markusg1234/ESP-Enclosure/esp-enclosure.scad

/* ===========================================================================
   ESP-Enclosure — a parametric ESP devkit case for OpenSCAD

   Copyright (c) 2026 markus1234
   Licensed under CC BY 4.0 — https://creativecommons.org/licenses/by/4.0/

   This model is an original design, written from scratch. It ships with
   slots.svg and wifi.svg, which are part of it and under the same licence.

   esphome.svg is NOT mine and NOT under CC BY 4.0: it is the ESPHome logo from
   Homarr Labs' dashboard-icons, under Apache 2.0, and modified. See
   "Third-party assets" in the README.

   IT IS WHAT THE LID CUTS BY DEFAULT — vent_file names it — so the attribution
   travels with anything you publish, print for someone else or sell. Point
   vent_file at slots.svg or wifi.svg, or set vents = false, and nothing here
   references it.

   The lid drops into a slot around the top of the wall and is held by ball
   latches: half-round bumps on its rib clicking into dimples in the slot wall.

   The devkit's two buttons — EN and BOOT — come up through that lid as a
   SEPARATE PRINTED PART each: a stem standing proud through a plain hole in the
   plate, a flange underneath that keeps the button captive, and a tip reaching
   down to the switch. The flange is the only part wider than the hole, so they
   are fed in from inside the lid, stem first, before the lid goes on. Print them
   with part = "button".

   Nothing on them flexes, and that is the whole point. This started as a
   printed flexure — the cap cut free on three spring arms so the lid stayed one
   part — and it broke after a few presses. Printed arms that survive one press
   do not survive a thousand.

   The board sits up on ledges; its header pins drop through a thin hole plate
   into a trough under each row. Dupont connectors push up into those troughs
   from below, so they finish flush with the floor instead of hanging out, and
   the wires leave straight down through the open underside.

   NO use<> OR include<> STATEMENTS. The geometry is all in this file, so the
   tray and the template render from it alone.

   The lid is the exception: its vents are cut from artwork in an SVG beside
   this one, named by vent_file. Three ship with it — esphome.svg (the ESPHome
   logo, the default, and the third-party one above), slots.svg (plain bars) and
   wifi.svg. That file has to travel with the model. Set vents = false and
   everything is standalone again.

   Open in OpenSCAD, then Window > Customizer. Pick a part with `part` at the
   top, press F6, then File > Export > STL.

   EVERY DIMENSION IS IN MILLIMETRES. The only settings that are not are the
   handful marked (in degrees), the plain counts, and the on/off switches.

   >> PRINT THE FIT TEMPLATE FIRST. Set part = "template". A shallow shell with
   >> the same footprint, the same interior outline and the same holes in the
   >> same places, so you can drop your actual board into it and see that it
   >> fits, that the header lines up and that the antenna has its bay — before
   >> committing to a whole case. The Dupont and board defaults below are
   >> sensible starting points, not verified specifications for your hardware.
   =========================================================================== */


/* [Part] */

// Which part to render
part = "tray";          // [tray:Tray (bottom), lid:Lid (top), button:Buttons - the two loose press buttons, template:Fit template - check your board fits, all:Print layout, assembled:Assembly preview]

// Gap between parts in the print layout (mm)
layout_gap = 5;         // [0:0.5:40]


/* [Pin header] */

// Pins per row. Two rows, one down each long side.
pin_count = 19;         // [1:60]


/* Centre-to-centre between the two rows, across the width. 22.86 is what most
   ESP devkits use; 25.4 is the other common one. (mm)
   */
// Centre-to-centre between the two pin rows, across the width. 25.4 is the other common one. (mm)
row_spacing = 22.86;    // [5:0.01:60]

/* Shift the whole header along the length: the holes, the pin channel, the
   Dupont troughs and the plinths that carry them, all together.

   NEGATIVE IS TOWARD THE USB END. The board itself cannot move — it sits hard
   against the inside of the USB wall so its socket meets the opening — so this
   is how you line the holes up with a header that is not centred on your board.

   The default is -1.0 because the header on a typical devkit sits that much
   closer to the USB edge than dead centre. Measure yours: it is the distance
   from the board's USB edge to the first pin, against the far edge to the last.
   */
// Shift the header along the length. Negative moves it toward the USB end. (mm)
pin_x_offset = -1.0;    // [-20:0.01:20]


/* [Pin pitch / Dupont preset] */

/* The three Dupont families, named by the thing you actually measure off your
   board: the pitch. Picking one sets the post size with it — 0.64 at 2.54,
   0.50 at 2.00, 0.40 at 1.27 — because a family is a pitch and a post together,
   not two things to line up by hand.

   This holds the pitch itself rather than a preset code, so the number in the
   dropdown is the number in the variable and there is nothing to decode.
   */
// Pin pitch: centre to centre along the header. Sets the Dupont post size too.
pin_pitch = 2.54;       // [2.54:2.54mm - standard, 2:2.00mm - compact, 1.27:1.27mm - micro]

/* Size the openings for the connector's PLASTIC SQUARE SURROUND instead of for
   the bare metal post, so a housed Dupont pushes up into the trough rather than
   only a naked crimp terminal. Off, everything is sized to the post, which is
   what it has always been.

   The surround is not a second measurement to take. Housings are moulded to
   TILE THE PITCH — that is exactly what lets a row of them sit shoulder to
   shoulder on a header — so their size IS the pitch, less the moulding gap that
   keeps two of them from jamming. 2.50 at the 2.54 preset, 1.96 at 2.00, 1.23
   at 1.27.

   That tiling is also why this tick MERGES THE ROW, and it is not a choice: at
   the 2.54 preset the opening becomes 2.70 against a 2.54 pitch, so the plate
   between one hole and the next is 0.32 mm of NEGATIVE material. There is no
   setting at which separate holes survive a surround. So while it is on:

   pin_slot      is on whatever it says — one continuous channel down the row
   pin_slot_w    is held at the opening's width if it is set below it
   pocket_wall   is 0 — the troughs merge into one slot down each row

   wire_channel_w is NOT one of them and keeps working normally. A wire channel
   is sized to the PIN, never to the surround: what goes along it is a wire off
   a pin, while the connector arrives from below and goes up through the plate.
   So it stays whatever you set — 0.84mm by default, with 1.70mm of rib between
   channels — exactly as with the tick off.

   The console says all of that when you tick it, so nothing goes quiet.

   terminal_len is worth a look alongside this, but there is no right answer to
   it and nothing warns: it is the trough's DEPTH, so it sets how much of the
   housing is buried and how much shows below the case. A housed Dupont is about
   15 mm, so at the default 6 roughly 9 mm of it is on display — which is a
   shorter case and an easier connector to unplug, if that is what you want.
   */
// Size the openings for the connector's plastic surround, not the bare pin.
dupont_housing = true;


/* Added to the post size to get the hole — or to the plastic surround, with
   dupont_housing ticked (mm). Raise if pins bind, lower if loose.
   */
// Added to the post (or the surround) to get the hole. Raise if pins bind. (mm)
hole_clearance = 0.2;  // [0:0.01:1.5]

// There is no lead-in chamfer on the holes, and no lead_in to set. The holes
// are plain square bores, top to bottom, at exactly `hole` across their whole
// depth.
//
// Losing the funnel costs less than it sounds like, because the hole is a
// CLEARANCE hole by construction: it is whatever has to pass through it plus
// hole_clearance, so it is already wider than that thing before anything is
// chamfered — half of hole_clearance per side. Against the bare post that is a
// hole 31% wider than the pin at 2.54 and 50% wider at 1.27; against a plastic
// surround the same slack is proportionally far less, because the surround is
// most of the pitch to begin with. Either way a pin was never being pressed
// into an interference fit that a funnel had to open up. The funnel only helped
// a pin FIND a hole it already fitted, and what does the finding is the pitch,
// which the header and the plate share.
//
// The exception is hole_clearance = 0, which the slider allows: that makes the
// hole exactly the post and there is no clearance left to speak of. Warned
// about below, since the funnel is no longer there to disguise it.

/* Replace the row of square clearance holes with ONE continuous channel running
   the length of the header. The pins still drop through it into the trough
   below and the terminals still push up from underneath — what goes away is the
   rib BETWEEN one hole and the next, which is what fails at a fine pitch: the
   1.27mm micro preset leaves pitch minus hole = 0.67mm of plate between holes,
   thinner than a single 0.4mm extrusion, so it prints as a smear rather than a
   wall.

   The price is location ALONG the row: nothing stops the header sliding
   lengthwise any more. The PCB rests and the board's own fit against the USB
   wall already do that.

   Forced on by dupont_housing, for the same reason at a coarser pitch: a
   surround leaves no rib between one hole and the next either.
   */
// Replace the row of holes with one continuous channel down each pin row.
pin_slot = true;

/* Channel width, and 0 is the default: as wide as a hole, which keeps the pins
   gripped across the row exactly as separate holes did. It is also the width that keeps the board where it is —
   see pin_slot, which only drops the board when the channel is wider than the
   header's strip.

   ANY OTHER VALUE GIVES THAT UP. At 4mm a 0.64mm pin has three millimetres of
   air around it: the channel is then clearance, not a fit, the pins are located
   in neither direction, and the board is held by its rests and the walls alone.
   That is a legitimate thing to want — it makes the pins trivial to drop in and
   leaves room to bring wires up beside them — but it is a different part.

   Keep it inside the pocket if you want the whole width to be a way through.
   Wider, and the channel is a wide pocket over a narrower opening: it still
   prints, and the pins still pass on the centreline, but only the pocket of it
   goes anywhere. The console tells you the opening you actually got.

   With dupont_housing on this is a request rather than the last word: anything
   below the opening's own width is raised to it, because a channel narrower
   than the surround is not a channel the surround goes through. Above it, it is
   yours as usual. (mm)
   */
// Pin channel width. 0 = as wide as a hole, which keeps the pins gripped. (mm)
pin_slot_w = 3;         // [0:0.1:10]

/* How far the channel cuts DOWN from the top face of the floor.

   There is a floor under this, and asking for less gets you the floor rather
   than an error: the channel has to get through the hole plate to reach the
   trough at all, so the minimum is hole_plate_t — 1.0 at the defaults. Below
   that it stops inside the plate and opens into nothing.

   Anything past the plate is optional. The trough is square, so the moment the
   channel breaks through it has the full pocket underneath it, and cutting
   deeper only removes more of the plinth. It is not the moving target it was
   when a tapering roof made the minimum depend on the trough and the roof angle.

   Ignored with the terminal recess off: there is no trough to reach, so the
   channel is simply cut through the floor the same depth the holes were. (mm)
   */
// How far the pin channel cuts down from the floor's top face. (mm)
pin_slot_depth = 3.0;   // [0.5:0.1:12]

/* A channel beside each pin hole, so you can bring a wire off a pin and out
   into the box instead of taking it down through the underside. It runs from
   the hole clear through the side of the plinth and opens onto the relieved
   floor.

   THE WIDTH IS THE SWITCH. 0 is no channel at all — plain holes — and any other
   value is that width in millimetres. There is no separate on/off tick: a tick
   and a width are two settings for one decision, and with both of them there was
   no way to see which one was the reason you had no channels.

   THE DEFAULT IS SIZED FOR THE WIRE, not for the pin: 1.2mm, which is 26 AWG
   with its insulation on, leaving 1.34mm of rib between one channel and the
   next at the 2.54 pitch. What travels down this channel is a wire, so the wire
   is what it is measured against. A channel at the pin's own 0.84 is narrower
   than common hook-up wire and the wire will not lie in it.

   That is a deliberate parting from the pin's hole, and the console reports it
   with both numbers so the rib you get is never a surprise. Matching the pin
   instead — 0.84 at 2.54, 0.70 at 2.00, 0.60 at 1.27 — is one number away, and
   it is the width at which the channels impose nothing the pin holes did not
   already impose. Nothing follows pin_pitch or hole_clearance on its own.

   The useful direction from here is DOWN. Narrowing buys back rib, which is the
   whole problem at a fine pitch: at the 1.27 micro preset even the pin's own
   0.60 leaves 0.67mm of plate and is too thin, while 0.45 leaves 0.82 and works.
   That is what makes wire channels possible there at all.

   Widening trades the other way, and the pitch caps it: two 0.4mm perimeters
   have to survive between one channel and the next. Ask for more and you get
   the most the pitch allows rather than an error, and the console says so.

   Every value on the slider does something:
   0             no channels
   under 0.4     raised to 0.4 — one extrusion. A narrower slot is not a slot,
                 the slicer simply fills it
   past the pitch the channels merge into one slot per row, which is a real part

   It is ONE setting, not the five it used to be — a tick plus slot_w, slot_neck,
   wire_w and slot_depth describing a keyhole with a neck, a wider section and
   its own length, every one of which could quietly break the channel.

   Works normally with dupont_housing on, and is unaffected by it. With the
   surround OFF the pin's hole is also the plate's hole, so the channel just
   continues it sideways. With it ON the hole is the surround's — 2.70 — and the
   channel deliberately does not follow: what goes along it is a wire off a pin,
   while the connector arrives from below. A 2.70 channel on a 2.54 pitch would
   merge every channel into one slot and take the inboard plinth wall with it.

   The direction and the length are not settings either, because neither has a
   second sensible value: it always runs toward the middle of the box, and
   always far enough to break clear through the plinth's side. Outboard is the
   side wall a couple of millimetres away, with nowhere to put a wire; stopping
   short of the plinth's face leaves a pocket the wire can never get out of.
   */
// Wire channel width, sized for the wire. 0 is no channel at all. (mm)
wire_channel_w = 1.2;   // [0:0.01:3]

/* How far the channel carries on BELOW the hole plate, into the trough.

   The channel has to pass through the plate to exist at all — that part is
   hole_plate_t and not a choice. This is the rest: the drop that opens a mouth
   into the trough's straight-sided section, so a wire can turn the corner and
   come out. Stop level with the plate's underside and that mouth is a sliver
   no wire fits through, which is what a 0 here gives you.

   AT THE CHANNEL'S OWN WIDTH THE MOUTH IS SQUARE, which is where the default
   sits: one width down for one width across. Shallower trades mouth for plinth,
   deeper costs nothing but the cut, so the useful direction is down only if you
   are short of plinth.

   Clamped to the trough's own depth, since past that there is nothing left to
   open into — and with a sealed base a deeper cut would breach the slab. With
   terminal_recess off there is no trough at all and this is held at 0: the
   channel is the plate's thickness and nothing more. The console says when the
   number you set was not the number you got. (mm)
   */
// How far the channel reaches below the hole plate, into the trough. (mm)
wire_channel_d = 1.2;   // [0:0.05:12]


/* [Terminal recess] */

/* Close the underside. The troughs are the only thing that opens through the
   bottom of the case, so this puts a slab of floor_solid under them and the
   case has no holes in its base.

   Nothing else changes: the pin holes, the troughs, the plinths, the wire
   channels and the rests all stay exactly as they are. The troughs simply
   become blind pockets, which is where the pin tails then sit — so a sealed
   base also removes any question of the tails fouling anything. The case grows
   by the thickness of the slab.
   */
// Close the underside with a solid slab, so the base has no holes in it.
seal_bottom = false;

/* Sink the Dupont connectors into a trough in the underside of the floor, so
   they finish flush instead of hanging below the case. The board sits up on
   its ledges, its pins drop through the hole plate, and the connectors push up
   into the trough from below. Wires leave straight out of the open underside.
   */
// Sink the connectors into troughs in the floor so they finish flush.
terminal_recess = true;

/* Trough depth, and therefore HOW MUCH OF THE CONNECTOR IS BURIED. Whatever is
   longer than this shows below the underside of the case.

   That is a dial, not a target. Bury the lot and the case is flush underneath
   but tall; leave some proud and the case is shorter and the connector is far
   easier to grip and unplug. About 6mm swallows a bare crimp terminal whole; a
   full plastic Dupont housing is nearer 15mm, so at 6 roughly 9mm of it shows.
   Neither is wrong, and nothing warns about it — set it to whatever leaves the
   amount of housing you want on display.

   It costs case height 1:1, because the floor is this plus hole_plate_t. That
   is the trade: every millimetre you bury is a millimetre of case. (mm)
   */
// Trough depth: how much connector is buried. The rest shows below the case. (mm)
terminal_len = 6.0;     // [1:0.1:25]

/* Material left above the pocket. The pin holes run through this, and it is
   what the pocket has to bridge when printed. Thinner leaves more pin for the
   terminal to grip; too thin and the holes tear out. (mm)
   */
// Material left above the trough, which the pin holes run through. (mm)
hole_plate_t = 1.0;     // [0.6:0.1:4]

/* Wall left between one pocket and the next. This is the ONLY thing that sizes
   a pocket, because the pockets are square and sit on the pitch: the pocket is
   whatever the pitch has left over, pitch - pocket_wall, the same in both
   directions. 1.74 mm square at the 2.54 preset.

   Ignored with dupont_housing on, which holds it at 0: a surround fills the
   pitch, so there is no room for a divider and the troughs have to merge.

   There is no trough_w any more. It set the pocket across the row while this set
   it along, which made the pockets rectangles — and it was the wrong shape to
   offer, because across the row the pocket had no reason to be anything other
   than what the pitch allows along it. Square, one number decides both.

   0.8 is two 0.4mm perimeters, the thinnest divider that prints as a wall
   rather than a smear. Set it to 0 and the pockets run together into one
   continuous trough down each row, which is the older behaviour and the only
   way a full-width crimp terminal fits at 2.54 pitch. (mm)
   */
// Wall between one trough pocket and the next. This is what sizes them. (mm)
pocket_wall = 0.8;      // [0:0.05:3]

// The troughs are square: straight sides from the underside of the case right
// up to the hole plate, so a connector can rise the whole way. There is no
// trough_roof_angle any more.
//
// They used to be roofed by a ridge, on the reasoning that a flat trough ceiling
// was an unsupported span inside a slot you could never clean support out of.
// It is not a span, it is a BRIDGE: a pocket is only `pocket` across and anchored
// on both its walls, so the slicer bridges the short way. 3mm at a 0.4 nozzle is
// routine, and support never enters into it.
//
// The ridge was costing more than it bought. It tapered the trough to nothing
// at the plate, so a terminal could only rise until the taper met its own width
// — about 1mm of grip at the old defaults, against the 3.8mm the console
// claimed, because that figure counted pin below the plate and ignored the roof
// in the way. Square troughs made the case 3.2mm shorter and made the reported
// grip the grip you actually get.

/* Relieve the floor down the middle, between the two troughs. Only the strips
   carrying the troughs need the full floor depth; the rest drops to floor_solid,
   leaving a raised plinth along each pin row. Each plinth runs from the side
   wall it is nearest to, in past its trough, so the board's long edge lands on
   solid floor rather than hanging over a trench. The outside of the case does
   not change — this only takes plastic out.
   */
// Thin the floor down the middle, leaving a plinth along each pin row.
floor_relief = true;

/* Material left each side of a trough. It is one of two demands on the plinth's
   width — the other is reaching the side wall — and the wider one wins, so this
   is a floor under the width rather than the width itself. Raise it and the
   plinth grows only while the trough is what is asking for the room; at the
   shipped defaults the side wall asks for more, and the console says so.
   */
// Material left each side of a trough. (mm)
plinth_wall = 1.2;      // [0.4:0.1:5]


/* [Board] */

// PCB length. 0 = derive from the header. (mm)
board_l = 0;            // [0:0.1:200]

/* YOUR BOARD'S WIDTH, measured across the PCB with calipers — not a lever on
   the case. It is one of the two demands on the case width; side_margin is the
   other, and the wider one wins.

   There is no board_side_margin and no board_clearance any more. Both measured
   the same span from a different end — row centre to the board's edge, and the
   board's edge to the wall — so three parameters described two distances and
   only ever one of them was live. What survives is the pair that cannot be
   confused: this one is your hardware, side_margin is the case. The gap between
   them is reported by echo() rather than requested, and warned about when it
   gets too tight to drop a board into. (mm)
   */
// Your PCB's width, measured across it. (mm)
board_w = 25;        // [10:0.1:200]

// Added each side of the header to get the auto PCB length (mm)
board_end_margin = 3.0; // [0:0.1:20]

/* THE HEADER SPACER'S HEIGHT — a measurement of your hardware, like strip_w or
   board_t. Not a lever: you are not setting how high the board rides, you are
   telling the model what the plastic block under it is.

   IT DOES NOTHING WHILE THE PIN CHANNEL SWALLOWS THE SPACER, which is the
   shipped default. The spacer sinks into the channel and the board lands on the
   plinth tops, so only the part TALLER than the channel is deep has any effect:

       board_under = max(0, pcb_standoff - pin_slot_depth)

   At the defaults that is zero for anything up to 3, and the tray mesh is
   byte-identical across 0, 1, 2 and 3. Raise pin_slot_depth to 5 and it is
   inert to 5. That is not a bug to chase; it is the board being datumed off a
   printed surface rather than off your spacer, which is the good case.

   WHERE IT IS LIVE: with dupont_housing AND pin_slot both off. Then there is no
   channel, the board rests on the spacer, and its height sets where the board
   sits — every value changes the mesh. That is the crimped-terminal mode.

   IT IS NOT THE LEVER FOR LIFTING THE PCB OFF THE BOTTOM OF THE BOX. Raising it
   pushes the board up OFF the pins, so it costs grip; and the floor shrinks
   underneath by the same amount, because the floor is sized to swallow the pin
   and there is less pin left below the board. The outside distance is

       bottom of box -> underside of PCB
           = max(pin_length, terminal_len + hole_plate_t + board_under)

   which is flat at pin_length until board_under gets large. For more room under
   the board use pin_length — it lifts the board AND buys grip, where this
   spends it. terminal_len deepens the trough the same way.

   Keep it just big enough to clear the solder joints. A standard 2.54mm header's
   block is about 2.5mm. (mm) */
// The header spacer's height: a measurement of your header, not a lever. (mm)
pcb_standoff = 1.2;     // [0:0.1:10]

/* How WIDE that plastic spacer is, across the row. MEASURE YOURS — about 3mm
   on the reference board, where the spacers under the module are roughly 3mm
   square.

   This is the one thing that decides whether the pin channel drops the board.
   The spacers are what the board actually rests on, so a channel narrower than
   one is bridged by it and the board sits where it always did; a channel that
   wide or wider swallows them and the board goes down with them, taking the
   flush USB opening and the case height with it.

   It used to be assumed equal to the pitch, on the reasoning that a header's
   moulding is one pitch wide. That is true of a continuous moulded strip and
   NOT true of the discrete spacers on a devkit, which run wider — so the model
   was testing 2.54 where the real number is 3, and would have missed the drop
   on exactly the channel width that causes it.

   There is no strip_l to go with it. The channel is continuous along the row,
   so how long a spacer is cannot change whether it falls in — only its width
   across the row can. (mm)
   */
// The header spacer's width across the row. MEASURE YOURS. (mm)
strip_w = 3.0;          // [0.5:0.1:12]

/* MEASURED OFF THE PCB: rest a caliper on the board's underside and read down
   to the tip of the pin. That is the whole tail — spacer and all — and it is
   the number this wants.

       PCB  ===================
              |  |   ^          spacer, pcb_standoff
              |  |   |
              |  |   |  pin_length = 9   <- underside of the board
              |  |   |                      to the tip of the pin
              |  |   v
                    ---

   The spacer is inside this, not additional to it. Read only the pin below the
   spacer and you get 6 where the answer is 9 — and that is not a mistake the
   model can catch: it believes you, and quietly builds a floor three
   millimetres too shallow for the pin that is really there.

   A pre-soldered devkit's stock tail is often only about 3mm off the PCB, which
   is not enough to cross the spacer and the hole plate AND still grip a
   terminal; this default assumes long-tail headers. With short pins, set
   terminal_recess = false.

   It drives the floor: the pocket is the larger of terminal_len and what the
   pin needs, so past a point the case grows to swallow the tail rather than let
   it out of the underside. The console prints the grip that is left, and it is
   an error at or below zero. (mm) */
// Measured off the PCB: its underside down to the pin tip, spacer included. (mm)
pin_length = 9.0;       // [1:0.1:20]

// PCB thickness. Only used to work out how tall the cavity has to be. (mm)
board_t = 1.6;          // [0.4:0.1:5]

/* The tallest thing standing on TOP of the board, measured from the board's
   upper face. 2.5 is the radio can on the reference board, which sits LEVEL
   with the top of the USB socket — measure yours. Raise it for tall
   electrolytics.

   The socket is allowed for automatically: the cavity takes the larger of this
   and the shell height usb_type already implies, so a tall connector cannot be
   forgotten here.

   It very rarely does anything. The cavity takes the larger of this and what the
   USB opening needs to clear the lid's rib, and the second beats it until
   component_h passes usb_oh + rib_h + 0.1. So it is NOT the lever for a shorter
   case; rib_h is. The console says which of
   the two is binding and how much dead air the other one is leaving. (mm)
   */
// Tallest thing standing on top of the board, from its upper face. (mm)
component_h = 2.8;      // [1:0.1:40]

// There are no PCB rest pads, and no ledge_d / ledge_w to size them. The four
// corner blocks that used to stand in the tray are gone: the board already sits
// on the header's plastic strip, and that strip lands on the plinth tops, so the
// pads were only ever stopping it rocking. The floor relief no longer has to
// spare a pillar under each one either.


/* [Case size] */

// Outer length. 0 = derive from the header. (mm)
length_override = 0;    // [0:0.1:250]

// Outer width. 0 = derive from the header. (mm)
width_override = 0;     // [0:0.1:250]

/* Clear air added at the FAR end, past the board, for the module's onboard
   antenna. Devkits mount the radio module hard against that end of the board
   and the antenna sits at the module's tip, often overhanging the board edge —
   so without this the module fouls the end wall and the antenna radiates into
   plastic pressed right against it. The case grows at the far end only: the
   USB end, the header, the troughs and the board all stay exactly where they
   are. MEASURE YOUR OWN BOARD — this default is a starting point. (mm)
   */
// Clear air past the board's far edge, for the module's antenna. (mm)
antenna_gap = 5;      // [0:0.1:30]

/* Row centre to the wall's inner face — the room beside the pins, measured out
   from a PIN ROW rather than from the board:

   interior = row_spacing + 2 x side_margin     (22.86 + 8.4 = 31.26)
   width    = interior + 2 x wall               (31.26 + 3.2 = 34.46)

   IT IS MEASURED TO THE INNER FACE, so it is clearance you can see inside the
   box and it does not carry the wall. Thicken wall and the case grows outward
   while the room beside the pins stays exactly where you put it: at 5.8 the
   interior is 31.26 whether the wall is 1.6 or 2.4, and the outside goes 34.46
   to 36.06.

   IT IS ONE OF TWO DEMANDS ON THE WIDTH, AND THE SMALLER ONE DOES NOTHING.
   The board needs pcb_w of interior, and the interior is whichever asks for
   more. They cross where side_margin = (pcb_w - row_spacing) / 2: below that the
   BOARD sets the width and moving this changes nothing whatever, above it this
   sets the width 1:1. Raising board_w moves that crossover up.

   So if it looks dead, it is losing the max(), not broken. The console prints
   the width it settled on and which demand set it.

   SCREW BOSSES ADD TO THIS INSTEAD OF FITTING INSIDE IT. A corner boss needs
   room across the width that the header does not, so closure = "screw" puts a
   full boss_d on EACH side on top of whatever side_margin asked for. The stock
   closure is "friction", where that does not apply and the row centre sits
   side_margin in from the inner face. Switch to screws and the case gains a
   full boss_d each side. Nothing here prevents that — the boss has to go
   somewhere. (mm)
   */
// Pin row centre to the INNER side face: clearance beside the pins. (mm)
side_margin = 3;      // [0:0.01:30]

/* Wall thickness. 1.6 is four 0.4mm perimeters, solid, and it is the reach a USB
   plug has to find before it even touches the socket — the socket sits against
   the inside of this wall, so every millimetre of wall is a millimetre off the
   plug's insertion depth. At 3.2 most micro leads simply do not bottom out: the
   moulded shell fouls the case first.

   It used to be 3.2 because the lid's groove was cut INTO the wall top and
   needed a lip either side of a 1.2mm slot. The rib hangs inside the wall now,
   so nothing here is holding a slot open and the wall can be as thin as it
   prints. Below about 1.05 the latch dimple has nothing left behind it. (mm)
   */
// Wall thickness, and the reach a USB plug has to find past it. (mm)
wall = 1.6;             // [1:0.05:6]

/* Floor thickness: the whole floor when the terminal recess is switched off,
   or the thin part between the plinths when the floor relief is on. (mm)
   */
// Floor thickness away from the plinths, or the whole floor with no recess. (mm)
floor_solid = 2.0;      // [0.8:0.1:8]

// Lid plate thickness (mm)
lid_t = 1.6;            // [0.8:0.1:8]

/* Interior height above the floor. 0 = derive it, as the standoff plus the
   board plus whatever stands on top of the board, which is as short as the box
   can be and still close. Set a number to pin it. (mm)
   */
// Interior height above the floor. 0 = derive it from what has to fit. (mm)
cavity_h = 0;           // [0:0.1:60]

// Outer corner rounding (mm)
corner_r = 3.0;         // [1:0.1:12]


/* [Closure] */

// How the lid is held on
closure = "friction";   // [friction:Rib and latches only, screw:Corner screw bosses]

/* Thickness of the rib under the lid — the part that drops inside the wall and
   locates it. 1.2 is three 0.4mm perimeters, stiff enough to carry the latch
   balls without being so stiff it will not flex past them. It no longer has to
   fit inside the wall, so it costs nothing in wall thickness. (mm)
   */
// Thickness of the rib under the lid that drops inside the wall. (mm)
rib_w = 1.2;            // [0.4:0.05:3]

/* How far the rib hangs below the lid, into the cavity. This is how much springy
   rib the latches have to work with, and how far the lid is located.

   THIS IS WHAT SETS THE CASE HEIGHT, and it is the only thing that does at any
   sane component height. The rib drops inside the wall, so the USB opening has
   to finish below it — and the socket is barely lower than the tallest thing on
   the board, so the air left over the components comes out at almost exactly
   rib_h + 0.1. Every millimetre here is a millimetre of wasted height, one for
   one.

   2.1 carries a 1.0mm latch ball with 0.55mm of rib above and below it, and is
   chosen to just lose to the components: the cavity is the larger of
   board_top + component_h and board_top + rib_h + 0.4, so anything up to
   component_h - 0.4 costs no height at all. Below about 2.0 the ball is more
   than half the rib and the latch loses its seat. (mm)
   */
// How far that rib hangs into the cavity. THIS SETS THE CASE HEIGHT. (mm)
rib_h = 2.1;            // [0.5:0.1:6]

// Clearance all round the joint. Raise if the lid is tight. (mm)
joint_clearance = 0.2; // [0:0.01:0.6]

// Screw clearance hole in the lid, e.g. 2.2 for M2 (mm)
screw_d = 2.2;          // [1:0.1:6]

// Pilot hole in the boss, e.g. 1.6 for an M2 self-tapper (mm)
screw_pilot_d = 1.6;    // [0.8:0.05:5]

// Screw boss outer diameter (mm)
boss_d = 4.5;           // [2:0.1:12]

/* Ball latches: half-round bumps on the lid's rib that click into dimples in the
   wall, so the lid latches rather than only gripping by friction. This is the
   one switch for all of them — which walls carry them, and whether there are any
   at all.

   THE ENDS are the default — the USB end and the antenna end, always two apiece.
   Two per end, never one: each end's rib has an opening notched out of its
   middle, and the balls go into the lid before that notch is cut, so a ball
   sitting in the notch's width would be sliced in half with it, and a single ball
   off to one side would cock the lid. Straddling the opening is the only
   arrangement that works there.

   Where the end pair sits across the width is derived, not set. Each takes the
   middle of the rib run left between the corner and the opening's edge, so
   changing usb_type, usb_fit or end_w moves them on its own, and they stay off
   the rounded corner where the wall's inner face curves away and a dimple would
   cut in at an angle. Where an opening is wide enough to leave no room at all,
   that end is skipped and the console says which one and why.

   THE LONG SIDES carry latch_count of them each, spread over the middle half of
   the length. Four balls either way at the defaults; `both` gives all eight.

   `none` is the friction fit on its own: the rib still drops inside the wall and
   still grips, but nothing holds the lid down. */
// Which walls carry the lid's ball latches.
latch_location = "ends";  // [none:None - friction fit only, sides:Long sides only, ends:Both ends only, both:Sides and ends]

/* How many latches down EACH long side. It starts at 1 because latch_location is
   what turns them off — a 0 here would be a second way to say the same thing.

   Ignored unless latch_location is sides or both, which the default is not: on a
   stock case this does nothing until you move the location off the ends. */
// How many down each long side. Ignored unless latch_location includes the sides.
latch_count = 2;        // [1:1:6]

/* How far the ball has to squeeze past the slot wall going in. This is the
   grip, and it is the number that has to survive your printer: below about
   0.25mm on a 0.4mm nozzle it disappears into dimensional tolerance and you
   get either no click or a seized lid, unpredictably. (mm)
   */
// How far the ball squeezes past the wall. This has to survive your printer. (mm)
latch_grip = 0.35;      // [0.1:0.05:1]

/* Slack in the tray's dimple so the ball seats instead of jamming on the way
   in. Comes straight off what is left of the lip, so do not be generous. (mm)
   */
// Slack in the dimple so the ball seats. Comes off the lip, so keep it small. (mm)
latch_fit = 0.10;       // [0:0.02:0.4]


/* [Openings] */

// Opening in the near end wall, for the USB socket
usb_opening = true;

/* Which connector your board has. These are FLUSH MOUNT: the opening is the
   socket's own metal shell plus a print fit, so the socket meets the wall
   instead of a big hole being left for the plug to pass through. The plug then
   mates from outside and its moulded shell sits against the case.
   Nominal receptacle shells, before the fit is added:
       Micro-USB B  7.5 x 2.5      Mini-USB B  7.7 x 4.0
       USB-C        8.95 x 3.2     USB-A       13.0 x 5.7
   Sockets vary less than cable overmoulds do, which is what makes flush mount
   worth doing — but measure yours, and use Custom if it disagrees.

   A flush opening has to LINE UP with the socket, which a generous one never
   had to: it is positioned automatically from the board stack, because the
   socket sits on the board's top face and nothing else decides where that is.
   Watch the console, which prints where it landed. */
// Which USB connector your board has. Sets the opening size and shape.
usb_type = "micro";     // [micro:Micro-USB B, c:USB-C, mini:Mini-USB B, a:USB-A, custom:Custom - set usb_w / usb_h]

/* How far the socket's shell stands PROUD of the board's edge. Measure it.
   About 1mm is typical; some boards mount the socket flush.

   Two things follow, and both matter more than they look.

   It is the plug's reach. The board sits hard against the inside of the end
   wall, so the socket's face ends up wall - usb_overhang from the outside — 0.6
   at the defaults, not the full 1.6. That is the difference between a lead
   seating and a lead fouling the case.

   And it is why the opening is NOTCHED up to the wall's top edge. A nose that
   overhangs has to END UP inside the wall, but it cannot GET there going
   straight down: there is solid wall above the opening, and the board drops
   vertically. The notch is the slot it slides down. Set this to 0 for a
   flush-mounted socket and the notch goes away with it. (mm) */
// How far the socket overhangs the board's edge. This is the plug's reach. (mm)
usb_overhang = 1.0;     // [0:0.05:4]

/* Opening width. Used only when usb_type = Custom, and taken as the finished
   opening rather than a shell size, so include your own fit. (mm)
   */
// Custom opening width, taken as the finished hole. Include your own fit. (mm)
usb_w = 12;             // [1:0.1:60]

/* Opening height. Used only when usb_type = Custom. This is usually what sets
   how TALL the case is: the opening has to finish below the lid's rib, so the
   cavity ends up as the opening's top plus rib_h. (mm)
   */
// Custom opening height, taken as the finished hole. (mm)
usb_h = 6;              // [1:0.1:40]

// Opening in the far end wall
end_opening = false;

// Far end opening width (mm)
end_w = 8;              // [1:0.1:60]

/* Far end opening height. 4.0 fits the cavity the case now has — it was 5,
   sized when the lid sat 4.7mm higher, and turning the opening on simply
   asserted. Unlike the USB end this is not positioned from anything, so it has
   to fit under the lid on its own: opening_z + this <= cavity. (mm)
   */
// Far end opening height. (mm)
end_h = 4;              // [1:0.1:40]

/* Height of the FAR END opening above the floor top. The USB opening is not
   set here: it is positioned automatically to meet the socket on the board's
   top face, which is the only place a flush mount can go. (mm)
   */
// Height of the far end opening above the floor's top face. (mm)
opening_z = 0.5;        // [0:0.1:30]

/* Slack in the USB opening, on top of the receptacle's own shell. It is the
   TOTAL, split either side, so 0.8 is 0.4 per side.

   The presets are nominal shells and real sockets are not: rolled edges, a
   flared lip, or a shell a tenth over drawing all stop a socket entering an
   opening cut to the book figure. Raise this and the opening grows around the
   same outline, so the micro/mini taper is kept — which is what going to
   usb_type = custom to get a bigger hole costs you.

   It changes the opening only, not the case: the cavity is measured from the
   shell, so the height does not follow it. Ignored with usb_type = custom,
   where usb_w and usb_h are the finished opening and the fit is already in
   whatever you typed. (mm)
   */
// Slack in the USB opening, total across the socket's shell. (mm)
usb_fit = 1;          // [0:0.05:3]


/* [Buttons] */

/* THE BOARD PICK LIST, and the switch that turns the buttons off.

   Pick your devkit and the buttons are placed for it — measured off the board's
   own USB-end corner, so a named entry follows board_w and the header rather
   than being pinned to a spot in the case. Resize the case and it keeps up.

   >> THE ENTRIES ARE ESTIMATES, NOT SPECIFICATIONS. They are where the buttons
   >> sit on a typical board of that family, the same standing this file's
   >> pin_x_offset = -1.0 has. MEASURE YOURS.

   Custom is for a board that is not on the list, or one of these that your
   calipers disagree with: it hands placement to the four coordinates below.

   >> WHY THE FOUR COORDINATES ARE NOT LIVE AT THE NAMED ENTRIES, AND WHY THEY
   >> HOLD REAL NUMBERS RATHER THAN 0. The Customizer cannot write one parameter
   >> from another — OpenSCAD reads each box's default out of this file and lets
   >> you edit it, and nothing in the panel computes. So a named entry cannot
   >> fill the boxes in. They used to sit at 0 meaning "use the entry", which
   >> made picking a board look like it had done nothing.
   >>
   >> They now default to the DevKitC positions, so the panel always shows a
   >> real place. Switch to Custom and you start exactly where the shipped board
   >> is, then move from there. The console prints the four figures for whichever
   >> entry you have picked, computed for the case you actually got, so copying
   >> a named entry into Custom is a paste rather than a calculation. */
// Which devkit's buttons to place. Custom hands it to the four coordinates below.
button_board = "devkitc"; // [none:None - no buttons, devkitc:ESP32-DevKitC 38-pin - EN and BOOT beside the USB, doit:DOIT DevKit v1 30-pin - EN and BOOT beside the USB, s3:ESP32-S3-DevKitC - RST and BOOT beside the USB pair, custom:Custom - place them with the four coordinates below]

/* WHERE EACH BUTTON IS, measured IN FROM THE CASE'S OUTER FACES — the two you
   can put a rule against on the finished print.

       case from above: USB end to the LEFT, y = 0 along the BOTTOM edge

       +--------------------------------------------------+
       |                                                  |
       |        (o) B  . . . . . . . . . . . . .  24.53   |
     [USB]                                                |
       |        (o) A  . . . . . . . . . . . . .   7.53   |
       |         :                                        |
       +---------+----------------------------------------+
       :         :
       :<- 8.1 ->:      devkitc, on the board this file ships with:
       :                    button_a_x = 8.1   button_a_y =  7.53
       x = 0                button_b_x = 8.1   button_b_y = 24.53

   x runs along the case from the USB end's outer face; y runs across it from
   the near long side's outer face, the one at y = 0 — the bottom edge above.
   Both are the case's own coordinates, so what you type is where it is, and
   what the panel shows is where it is.

   >> THESE ONLY PLACE ANYTHING AT button_board = custom. At a named entry the
   >> board places the buttons and these sit here as the starting point you get
   >> if you switch — which is why they hold real figures rather than 0. The
   >> console says so rather than letting them look connected.
   >>
   >> The defaults are the ESP32-DevKitC positions for the board this file ships
   >> with, so Custom starts exactly where devkitc leaves off. For the other two,
   >> on this same board:
   >>
   >>     board                        a_x    a_y    b_x    b_y
   >>     ESP32-DevKitC 38-pin         8.1    7.53   8.1   24.53   <- shipped
   >>     DOIT DevKit v1 30-pin        7.6    7.53   7.6   24.53
   >>     ESP32-S3-DevKitC             9.6    8.03   9.6   24.03
   >>
   >> Those are for THIS case size. Change board_w, side_margin, or switch to
   >> screw closure and the case gets wider, which moves the board's edges away
   >> from y = 0 and puts the y figures off the mark. A NAMED ENTRY IS IMMUNE —
   >> it re-derives from where the board actually is — and the console reprints
   >> the four numbers for whatever case you got.

   >> THE USB END IS THE STABLE ONE. The board sits hard against the inside of
   >> that wall, so x is fixed against your board and only `wall` moves it —
   >> grow the antenna bay, change pin_count, override the length, and a button
   >> at x 8.1 stays over the same spot on the PCB.
   >>
   >> ACROSS THE WIDTH IT IS NOT. The board is centred, so anything that widens
   >> the case — side_margin, board_w, width_override, or closure = screw, which
   >> adds a whole boss_d each side — moves the board's edges away from y = 0
   >> and slides your button relative to the board. The console prints each
   >> button both ways, in from the case's faces and in from the board's own
   >> USB-end corner, so that drift shows up on the line rather than in a print.

   There is no magic value: at Custom each of these four is the position,
   exactly as typed. (mm) */
// Button A from the USB end's outer face. Used at button_board = custom. (mm)
button_a_x = 8.1;       // [0:0.01:250]

// Button A from the near side's outer face. Used at button_board = custom. (mm)
button_a_y = 7.53;      // [0:0.01:250]

// Button B from the USB end's outer face. Used at button_board = custom. (mm)
button_b_x = 8.1;       // [0:0.01:250]

// Button B from the near side's outer face. Used at button_board = custom. (mm)
button_b_y = 24.53;     // [0:0.01:250]

/* HOW TALL THE SWITCH IS above the board's top face — the actuator's top, not
   the body's. A measurement of your hardware, like component_h or board_t, and
   the model has no way to guess it.

   It is what the button's tip has to reach down to, and it is a demand on the
   cavity in its own right: a switch taller than the air over the board would be
   held down by the closed lid. The cavity takes the largest of three demands and
   the console says which one won.

   A 4.5 x 4.5 SMD tact — the usual devkit part — stands about 1.5 above the
   PCB, which is well under the 2.5 the radio can needs. It is the FLANGE, not
   the switch, that makes the buttons cost height here. (mm) */
// How far the switch's actuator stands above the board's top face. (mm)
button_h = 1.5;         // [0.3:0.1:10]

/* The air left under the button's tip when it is sitting at rest, and it is the
   number that decides whether your case holds BOOT down forever.

   The switch's own dome is what holds the button up: it is far stiffer than a
   fraction of a gram of plastic, so it pushes the button until its flange meets
   the lid's underside. This is the clearance left at that position — press it
   and the tip crosses this, then the switch's own quarter millimetre.

   Do not take it to zero. A button that prints a tenth long would then rest
   pre-loaded on the switch, and a tenth more than that actuates it. (mm) */
// Air under the button's flange at rest. Too little and the case holds the button on. (mm)
button_gap = 0.3;       // [0.1:0.05:2]

/* THE WHOLE BUTTON'S WIDTH — the flange, which is also the flat face that goes
   on the bed and the flat face that presses the switch. Everything follows it:

       flange     button_d           the widest thing on the part
       hole       button_d - 2.0     what the lid gets
       stem       hole - button_fit  through the hole, and the top you press

   The 1.0 mm shoulder each side is derived. It is the lip the flange catches on,
   and there is no second sensible value: less than about two perimeters is a lip
   that shears off, and more is only a narrower button behind the same flange.

   >> THE FLANGE IS THE ONLY WIDE END, and it has to stay that way. The button is
   >> fed in from inside the lid, so the whole stem — the pressed top included —
   >> passes through the bore. Putting a wide head on top as well makes a part
   >> that cannot be assembled at all: discs bigger than the hole at both ends,
   >> with no way in short of moulding the lid around it.

   >> 5.0 IS ALSO THE PRINT. Flange down on the bed, the first layer is the full
   >> 5.0 disc and every step above it goes INWARD, so there is no overhang
   >> anywhere on the part — see buttons(). A wider flange only makes the bed
   >> contact bigger; it does not buy anything.

   5.0 gives a 3.0 hole and a 2.7 stem, and leaves 2.03 mm between the flange and
   the lid's rib on a devkit-width case. The console prints that gap. (mm) */
// The button's width: the flange, the flat bottom, and what presses the switch. (mm)
button_d = 4.5;         // [3:0.1:20]

/* HOW FAR THE STEM STANDS ABOVE THE LID at rest — proud enough to find by feel
   without looking, and to still be proud once you have pressed it.

   That second part is the constraint: the button travels button_gap plus the
   switch's own quarter millimetre before it clicks, so anything under about
   0.6 disappears level with the plate at the bottom of the stroke and you are
   pressing a hole. 1.2 is six 0.2 mm layers and leaves half of it showing. (mm) */
// How far the stem stands proud of the lid's top face at rest. (mm)
button_proud = 2;     // [0.2:0.1:6]

/* THE FIT BETWEEN THE STEM AND ITS HOLE, taken off the stem's diameter so the
   lid's hole stays the number you asked for. This is the one dimension a
   separate button lives or dies by, and it is the one the model cannot know:
   it is your printer's elephant's foot, your shrinkage and your slicer's
   compensation, not a property of the design.

   0.3 total — 0.15 a side — slides freely on a well-tuned 0.4 mm nozzle. Raise
   it if the button binds, lower it if it rattles. It is a clearance, never an
   interference: a button pressed into its hole is a button that stops moving.
   (mm) */
// Clearance between the stem and the lid's hole. Raise if it binds, lower if it rattles. (mm)
button_fit = 0.4;       // [0.05:0.05:1]


/* [Lid] */

/* Text engraved into the lid. Blank for none, which is the default — the
   engraving is the only thing on the lid that needs bridging, so leaving it
   off takes the lid to zero overhang.
   */
// Text engraved into the lid. Blank for none.
label = "";

// Label size (mm)
label_size = 6;         // [2:0.5:20]

// How deep the label is engraved (mm)
label_depth = 0.6;      // [0.2:0.05:2]

/* Where the label sits along the length. 0 = auto, centred in the space
   between the USB end and the vent patch. (mm)
   */
// Where the label sits along the length. 0 = auto, centred in the space left. (mm)
label_x = 0;            // [0:0.1:250]

/* Turn the label, in degrees, counter-clockwise as you look down at the closed
   case. -90 stands it on its side reading down the case, 90 reading up it.
   Unlike the vents there is no quarter turn built in: 0 is as you typed it.
   */
// Turn the label. 0 is as you typed it. (degrees)
label_rotate = 0;       // [-180:5:180]

/* Ventilation over the radio module. The module is the only part of a devkit
   that gets meaningfully warm, so the openings sit over it rather than being
   spread across the lid — the rest of the plate stays solid and stiff.
   */
// Cut vent artwork through the lid, over the radio module.
vents = true;

/* Centre of the vent patch, measured from the board's FAR edge (the end away
   from USB, where the radio module sits on most devkits). (mm)
   */
// Centre of the vent patch, measured from the board's far edge. (mm)
vent_from_end = 10;     // [0:0.5:80]

// Length of the vent patch, along the case (mm)
vent_zone_l = 15;       // [2:0.5:80]

/* Width of the vent patch, across the case. Used by the slots, and by
   vent_fit = stretch. With vent_fit = aspect it is not used at all: the
   artwork is scaled to vent_zone_l and its own proportions set the height.
   Millimetres.
   */
// Width of the vent patch, across the case. (mm)
vent_zone_w = 15;       // [2:0.5:60]


/* [Vent artwork] */

// How the artwork is scaled into the vent patch.
vent_fit = "aspect";    // [aspect:Keep its proportions, stretch:Fill the patch exactly]

/* Turn the artwork on the lid, in degrees, counter-clockwise as you look down
   at the closed case.

   Zero is not "as drawn": artwork is laid down a quarter turn CLOCKWISE from
   how it sits in the file, which is what puts the shipped wifi.svg the right
   way round on the lid. This setting turns it further from there, so 0 is the
   orientation you want and you only touch it to deviate.

   Applied before the artwork is scaled, so vent_zone_l always measures across
   the finished orientation.
   */
// Turn the vent artwork before it is cut. (degrees)
vent_rotate = 0;        // [-180:5:180]

/* The artwork cut into the vent patch, which has to sit next to this file.
   Three ship alongside — esphome.svg (the default), slots.svg (plain bars) and
   wifi.svg; drop in your own and name it here.

   esphome.svg is the one file here that is NOT under this model's licence: it
   is the ESPHome logo, Apache 2.0, and the default lid cuts it. See the header
   and "Third-party assets" in the README before you publish or sell a lid. The
   other two are part of the model.

   >> THE LID NEEDS THIS FILE. Vents are always cut from artwork now, so the
   >> model is only standalone with vents = false.
   */
// Artwork file for the lid vents. It must sit beside this .scad.
vent_file = "esphome.svg";

/* SVG imports as a true outline. PNG is read as a heightmap and thresholded,
   which leaves the edges stepped by the pixel grid — measured on a disc, a PNG
   wobbled 0.75mm on a 10mm radius where the SVG was exact. Prefer SVG.
   */
// Artwork format. SVG is a true outline; PNG is traced and wobbles.
vent_format = "svg";    // [svg:SVG - a true outline, png:PNG - stepped edges]

// PNG only: brightness cut-off. Pixels brighter than this become openings.
vent_level = 50;        // [0:1:100]

// PNG only: cut the dark parts instead of the light ones
vent_invert = false;


/* [Fit template] */

/* Floor thickness of the fit template. Two or three layers is plenty — it only
   has to hold its shape while you drop the board in and look. (mm)
   */
// Floor thickness of the fit template. (mm)
template_t = 1.2;       // [0.4:0.1:4]

/* How high the template's wall stands. Enough to catch the board's edges and
   show you it clears, without printing a whole case. (mm)
   */
// How high the fit template's wall stands. (mm)
template_rim = 3.0;     // [0:0.1:15]


/* [Quality] */

// Facets per full circle. 100+ for a final render, 30 for a fast preview.
$fn = 200;               // [12:200]


/* [Hidden] */


// --- USB connector lookup --------------------------------------------------
/* Flush-mount opening: the receptacle's own shell plus usb_fit, which is set
   with the other opening parameters. Derived here because opening_top, the
   cavity height, the openings themselves and both opening asserts read these,
   and every one of those is further down the file. */
usb_ow = usb_type == "micro" ? 7.50  + usb_fit
       : usb_type == "c"     ? 8.95  + usb_fit
       : usb_type == "mini"  ? 7.70  + usb_fit
       : usb_type == "a"     ? 13.00 + usb_fit
       : usb_w;

usb_oh = usb_type == "micro" ? 2.50 + usb_fit
       : usb_type == "c"     ? 3.20 + usb_fit
       : usb_type == "mini"  ? 4.00 + usb_fit
       : usb_type == "a"     ? 5.70 + usb_fit
       : usb_h;

// usb_z is further down, with board_drop — where the board sits is not settled
// until the pin channel has had its say. See "Where the board actually sits".


// --- Dupont preset lookup -------------------------------------------------
/* No struct type in the Customizer, so presets are a ternary chain.

   There is no Custom entry, and no pin_pitch or custom_post to feed it. Those
   three settings only did anything at ONE of the four dropdown values and sat
   inert at the other three — a pitch slider that moves nothing is exactly the
   broken slider this file keeps taking out. The three presets are the three
   Dupont families; anything else is a different connector, not a tuning of
   this one.

   The last branch is a plain else rather than a test for 1.27, so the chain
   cannot fall through to undef. That makes an out-of-range pin_pitch read as
   the 1.27 post instead, which the assert below catches rather than letting you
   print a micro-pitch case by accident. */

post = pin_pitch == 2.54 ? 0.64
     : pin_pitch == 2.00 ? 0.50
     :                     0.40;

assert(pin_pitch == 2.54 || pin_pitch == 2.00 || pin_pitch == 1.27,
       str("pin_pitch ", pin_pitch, " is not one of the three Dupont families. ",
           "Use 2.54 (standard), 2.00 (compact) or 1.27 (micro). There is no ",
           "Custom any more, and no custom_post: they did nothing at every ",
           "value but that one."));

/* The plastic surround, and why it is derived rather than a fourth entry in the
   chain above.

   A housing is moulded to TILE THE PITCH — that is the whole point of it, so a
   row of connectors sits shoulder to shoulder on a header without fouling.
   Its size is therefore not an independent measurement the way the post is: it
   is the pitch, less the moulding gap that stops two of them jamming. 2.50 at
   the 2.54 preset, 1.96 at 2.00 and 1.23 at 1.27 — three presets, three
   numbers, no parameter of its own.

   post_eff is what actually has to pass through the plate. Everything below
   reads `hole`, so putting the choice HERE — in one place, above `hole` — is
   what keeps the template and the tray describing the same opening. */
housing  = pin_pitch - 0.04;
post_eff = dupont_housing ? housing : post;

hole  = post_eff + hole_clearance;

/* What a BARE PIN needs, whatever the surround is doing. Two things want this
   number and both want it for the same reason, so it is named once rather than
   spelled out twice: the wire channel (a wire comes off a pin, not off a
   housing) and the fit template's pin row, which has to keep answering "do my
   pins line up" even with the surround on, or it is measuring the wrong thing.

   With dupont_housing off this IS `hole`. With it on they part company — 0.84
   against 2.70 at the 2.54 preset — which is exactly why it needs its own name. */
pin_hole = post + hole_clearance;

/* The wire channel is sized to the PIN, not to the surround, and that is the
   difference between the feature working with a housing and being impossible
   with one.

   What travels along this channel is a WIRE coming off a pin — it is not a way
   in for the connector, which arrives from below and goes UP through the plate.
   So the thing it has to clear is the post, and the surround never enters into
   it. Tying it to `hole` was right while `hole` was the post's; with a surround
   it would ask for 2.70 on a 2.54 pitch, merge every channel into one slot down
   the row, and take the whole inboard plinth wall with it.

   At the post's width the rib between two channels is pitch - channel_w, the
   same 1.70 mm it has always been, so the channels stay separate and printable
   at every preset — surround or no surround. With the tick off this IS `hole`,
   so nothing about the default part changes.

   wire_channel_w overrides that width. It is clamped at the BOTTOM only:

     channel_min   one 0.4mm extrusion. A slot narrower than the nozzle is not a
                   slot — the slicer fills it — so asking for less gets 0.4.
     channel_max   what the pitch leaves after two 0.4mm perimeters of rib. This
                   is REPORTED, not enforced: see below.

   There is deliberately NO upper clamp, and that is a correction. Clamping the
   top at channel_max left the slider dead above 1.74 at the 2.54 preset — a
   third of its travel doing nothing, which is the same broken slider as one
   that asserts, just quieter. Past the pitch the channels simply MERGE, the way
   pin_slot merges the holes and pocket_wall = 0 merges the pockets, and the row
   becomes one continuous slot out through the plinth's side. That is a real
   part — a full-length wire exit — not an error to be prevented.

   Between the two the ribs are thinner than two perimeters but not yet gone.
   That band warns rather than clamps, which is exactly how pocket_wall's own
   too-thin dividers are handled: it prints, it is just fragile, and how fragile
   depends on a nozzle the model cannot know.

   The bottom clamp only applies to an EXPLICIT width. Left at 0 the derived
   width is passed through untouched, so a pitch too fine for a pin-wide channel
   still fails the rib check rather than being silently narrowed — there is no
   request to honour in that case, only a default. */
channel_min  = 0.4;
channel_max  = max(channel_min, pin_pitch - 0.8);

/* The width IS the switch, so "are there channels at all" is read off it rather
   than off a tick of its own. Internal, and below the last parameter group, so
   it stays out of the Customizer — everything downstream still reads
   `wire_channels` the way it always did. */
wire_channels = wire_channel_w > 0;

// 0 when there are none, so channels_merged and every message downstream cannot
// quote a width for a channel that does not exist
channel_w = wire_channels ? max(wire_channel_w, channel_min) : 0;

/* Wide enough that one channel reaches its neighbour. Cut as ONE slot from
   there on — a row of cubes at exactly `pitch` across on a `pitch` spacing
   butts face to face, and butting one cut onto another is what gives this model
   non-manifold edges and a negative genus. Same trap the pockets fell into. */
channels_merged = channel_w >= pin_pitch - 0.001;

/* What the surround takes over, and why it could not be left set.

   With dupont_housing on the opening is most of a pitch wide before
   hole_clearance is added at all, so at the default clearance it is WIDER than
   the pitch: 2.70 against 2.54. The plate between one hole and the next is then
   negative material, and so is the wall between one pocket and the next. No
   value of pocket_wall or pin_slot rescues that, because it is the connector's
   own shape doing it.

   wire_channel_w is NOT on this list. It used to be, on the reasoning that a
   surround leaves no rib to run a channel through — but that was the surround's
   width being applied to a cut that never needed it. Sized to the post, as
   above, the channels are unaffected by the tick and stay entirely the user's.

   So the tick derives these two rather than asserting against them — a slider
   whose range is unreachable is a broken slider, and a checkbox that errors is
   worse. The console says what was taken over, so nothing goes dead quietly.

   Defined HERE, straight after `hole` and before `pocket`, for the same reason
   `pocket` is: a forward reference at file scope is undef, it propagates in
   silence, and this file has lost every pin pocket to exactly that three times
   while OpenSCAD reported NoError. */
pocket_wall_eff = dupont_housing ? 0     : pocket_wall;
slot_on         = dupont_housing ? true  : pin_slot;

/* The pocket is SQUARE — the same across the row as along it — and the pitch is
   what sizes it. Along the row it can be at most pitch - pocket_wall_eff or it
   touches its neighbour, and across the row there is no competing demand, so
   there is nothing to gain by making the two differ. One number, one shape.

   Never smaller than the hole above it, though: a pocket narrower than its own
   hole would choke the pin it exists to receive. At the 1.27 preset that clamp
   bites and the divider comes out thinner than asked, so pocket_gap reports what
   was actually left and the check below compares it against the request rather
   than trusting it.

   Defined HERE, straight after `hole`, because half the file reads it: the
   plinth width, the floor relief, the pin channel's opening and the pockets
   themselves. Used above its assignment it is undef, which propagates silently
   into the pocket cubes and deletes every pocket in the tray while the render
   still reports NoError and a plausible genus. This file has been bitten by
   exactly that twice. */
pocket     = max(hole, pin_pitch - pocket_wall_eff);
pocket_gap = pin_pitch - pocket;

/* Whether the pockets still stand apart, or have run together into one trough.

   This is a geometry decision, not just something to report. A pocket exactly
   `pitch` long on a `pitch` spacing — pocket_wall at 0, or a plastic surround
   at a clearance under the moulding gap — leaves each cube BUTTING its
   neighbour face to face, and butting one cut exactly onto another is how this
   model makes non-manifold edges. It renders Status: NoError and reports a
   NEGATIVE genus, which is the tell.

   So terminal_troughs() cuts one long trough instead of a row of touching
   cubes whenever this is true. The two are exactly the same extent — the union
   of the cubes runs trough_x0..trough_x1 the moment pocket >= pitch — so
   nothing moves; what goes away is the interior faces that never had any
   business being there. */
pockets_merged = pocket_gap <= 0.001;


/* Sealing the bottom does not take anything away: the holes, the troughs, the
   plinths and the wire channels all stay. It just puts a slab of floor_solid
   under the troughs, which are the only things that open through the underside.
   The troughs become blind pockets — which is exactly where the pin tails want
   to go — and the case grows by that slab. */
base_t = seal_bottom ? floor_solid : 0;

// what a pin actually has to pass through: the thin plate when the recess is
// on, the whole floor when it is off. Independent of the pocket's depth, which
// is why everything below can be settled before the floor is.
plate_t   = terminal_recess ? hole_plate_t : floor_solid;

/* The pin channel's width and depth, and where the board ends up.

   All of this sits ABOVE the floor because the pocket's depth now depends on
   where the board lands, and the board lands on the header's strip — or in the
   channel, if the channel is wide enough to swallow it. slot_min_depth is
   plate_t outright rather than floor_t - plate_z; those are the same number
   (the floor is the pocket plus the plate, and plate_z is the top of the
   pocket), and writing it directly is what breaks the loop. */
/* Width is clamped UP to the opening with a surround, rather than replaced by
   it. pin_slot_w stays a live setting either way — ask for more than the
   surround needs and you get it, the same as always; ask for less and you get
   the least that lets the connector through, which is the only value that is
   not simply broken. */
slot_cut_w     = max(pin_slot_w > 0 ? pin_slot_w : hole,
                     dupont_housing ? hole : 0);
slot_min_depth = plate_t;
slot_cut_d     = terminal_recess ? max(pin_slot_depth, slot_min_depth) : plate_t;

/* The header's plastic strip drops into a channel wider than itself.

   A plastic surround does NOT change this, and an earlier version of this file
   wrongly assumed it did — it suppressed the drop on the reasoning that the
   housings rise to the floor's top face and the strip lands on them. They do
   rise, but they are not standing on anything: a housed Dupont is pushed up
   from below and held by friction on its pin, over a trough that is open at the
   underside. It follows the board down; it cannot hold the board up. The one
   case where a connector does push back is a SEALED base, where it bottoms out
   on the slab — and that already has its own warning about lifting the board.

   So dupont_housing gets the ordinary rule. It forces slot_on, so with a
   channel that swallows the spacers the board drops exactly as it would with
   the tick off.

   The test is strip_w, not pitch. What the board rests on is the plastic
   spacers, and on a devkit those are wider than the pitch — about 3mm against
   2.54. Testing the pitch would have said "drops" for a 2.6mm channel that a
   3mm spacer actually bridges, and it is a measurement only the user has.

   "At or wider", not "wider than", because a channel exactly the spacer's width
   is the case you hit by setting them to the same number, and it is a drop, not
   a bridge. The epsilon is written out rather than using `fuzz`, which is
   declared further down this file and would be undef here — an undef comparison
   is false, so the drop would silently never happen and the render would still
   report NoError. */
board_drop = (slot_on && terminal_recess && slot_cut_w + 1e-6 >= strip_w)
           ? min(slot_cut_d, pcb_standoff) : 0;

// board faces, both measured from the floor's top face
board_under = pcb_standoff - board_drop;
board_top   = board_under + board_t;

/* How deep the pocket has to be, and it is the larger of two separate demands.

   terminal_len is how much CONNECTOR you need to bury for it to finish flush.
   The other is how much PIN there is to swallow: a tail longer than the pocket
   comes out through the underside. They are not two names
   for one thing — a longer pin does not make a connector bigger — but they both
   land on this one dimension, so it takes whichever asks for more.

   That is what makes pin_length change the case at last. It only ever grows it:
   cut the pins short and the connector still needs its room, so lower
   terminal_len too, or switch terminal_recess off and let the connectors hang
   below. Solder straight to the board and you want terminal_recess off anyway —
   there is no connector to bury and no pin to swallow. */
pin_pocket_need = max(0, pin_length - board_under - hole_plate_t);
pocket_d        = max(terminal_len, pin_pocket_need);

/* With the recess on, the floor is exactly the pocket plus the plate that
   carries the holes — nothing between them, because the pocket is square and
   runs straight up to the plate's underside. Sealed or recess-off, it is a plain
   slab of floor_solid. */
floor_t   = base_t + (terminal_recess ? pocket_d + hole_plate_t : floor_solid);
trough_z  = base_t + (terminal_recess ? pocket_d : 0);
plate_z   = trough_z;                             // underside of the hole plate
slot_break_z = plate_z;
// The hole is the plate and only the plate. With a square trough there is no
// taper below it to punch through first — the plate's underside IS the trough.
hole_z0   = plate_z;
hole_h    = plate_t;

/* The holes have no lead-in chamfer, which takes a whole class of error out of
   the model along with the feature. A funnel is cut from the top down, so it had
   to be capped at half the plate or it broke out of the underside and the hole's
   narrowest point stopped being `hole` at all — worst on the thinnest plate,
   which is exactly backwards. There was a lead_angle before that, defaulting to
   65 degrees, which cut 1.07mm into a 1.00mm plate and left holes 0.1mm
   oversize. A plain bore cannot do any of that: it is
   `hole` wide at the top, at the bottom and everywhere between. */


/* The continuous pin channel — how wide, how deep, and how deep it MUST be.

   Width is its own parameter because it is a different decision from the hole's.
   At `hole` the channel is still a fit; wider, it is clearance and the pins
   float in it. Nothing downstream cares which,
   so both are just slot_cut_w.

   With the recess on, the depth is measured down from the floor's top face and
   pin_slot_depth chooses it. With the recess off there is no trough under the
   plate and nothing to choose: the channel goes through the same material the
   holes went through, so it is plate_t deep and the parameter is ignored.

   `slot_break_z` is the highest the channel's floor may sit and still let a pin
   through, and with a square trough that is simply the plate's underside. The
   pocket below is `pocket` wide from there all the way down, so the channel
   either reaches the plate's underside and opens into the full trough, or stops
   inside the plate and opens into nothing. There is no partial case any more —
   the ridge used to give one, tapering the void so the channel could break into
   a slit narrower than a pin, and half the arithmetic here existed to find the
   height where that slit was still `hole` wide.

   slot_min_depth is a FLOOR, and the depth is clamped up to it rather than
   asserted against. Asking for less gets the least that works, and the console
   says so. */
slot_z0 = floor_t - slot_cut_d;   // the rest of this lives above floor_t

/* Where the board actually sits, and the USB opening with it.

   The board is carried on the header's plastic strip, and the strip lands on
   the plinth tops. Switch pin_slot on and there may not BE a plinth top under
   it any more: the channel is cut down the middle of the row, and if it is
   wider than the strip the strip drops straight into it until it grounds on the
   channel floor. The whole board goes down with it.

   What the board rests on is the plastic spacers, so the test is slot_cut_w
   against strip_w — about 3mm on a devkit, wider than the 2.54 pitch this used
   to assume. At the default pin_slot_w = 3 the channel is exactly that, so the
   spacers drop in and the board goes down with them. Set pin_slot_w = 0 and the
   channel is `hole` wide, 1mm, the spacers bridge it, and switching pin_slot on
   moves nothing.

   How far it goes is capped by the BOARD, not the channel. The strip sinks
   until either it grounds on the channel floor or the board's own underside
   reaches the plinth top — and the board is the whole width of the case against
   a channel a few millimetres wide, so it lands flat long before a deep channel
   runs out. That cap is the strip's own height, which is what pcb_standoff is.
   Without it a 3mm channel drops the board 3mm, puts its top face BELOW the
   floor, and asks for a USB opening at a negative height.

   This is not cosmetic. It moves the pins further into the pockets, moves the
   board's top face away from the lid, and moves the USB socket — and a flush
   opening that does not follow is a hole in the wrong place. */

// the shell stands on the board's top face; back off half the fit to centre it
usb_z = board_top - usb_fit / 2;

/* The notch, and what a plug actually has to reach.

   usb_notch_z is where the slot starts: at the profile's WIDEST point, so the
   two merge without leaving ears. For a trapezoid that is its top edge; for the
   obround it is mid-height, where the caps are at full width. */
usb_notch   = usb_opening && usb_overhang > 0;
usb_notch_z = usb_type == "c" ? usb_z + usb_oh / 2 : usb_z + usb_oh;
usb_reach   = wall - usb_overhang;      // outer face to the socket's face

/* How far the board is pushed off the USB end wall, and why it is only ever
   pushed when there is NO opening.

   The board sits hard against the inside of that wall so its socket lines up
   with the opening. But the socket OVERHANGS the board's edge by usb_overhang,
   so flush against the wall it is protruding usb_overhang INTO the wall — which
   is exactly what you want when there is a hole there for it to protrude into.

   Switch usb_opening off and there is no hole: that millimetre of socket is
   then inside solid plastic, and the board cannot go in. So the board steps
   back by the overhang and the socket's face lands on the wall's inner face
   instead, fully inside the box.

   The case grows by the same amount rather than the antenna bay absorbing it —
   antenna_gap is clear air you measured for a reason, and silently eating it to
   pay for this would be the wrong trade. With an opening this is 0 and nothing
   moves at all. */
usb_inset = usb_opening ? 0 : usb_overhang;


/* How much of the channel's floor is actually open.

   The trough is square, so once the channel reaches the plate's underside the
   opening is the full pocket — no taper, no depth dependence. slot_ledge is
   the solid shelf left each side when the channel is wider than the trough it
   lands on.

   The shelf is NOT an overhang, which is worth stating because it looks like
   one on paper: it is the top of solid plinth, so it faces UP into the channel.
   What it does mean is that a channel wider than the pocket is a wide slot over
   a narrower hole, and only the pocket of it goes anywhere. Unlike before,
   widening the trough now fixes that directly. */
slot_void_w = terminal_recess ? pocket : 0;
slot_ledge  = terminal_recess ? max(0, (slot_cut_w - slot_void_w) / 2) : 0;


// --- Derived dimensions ---------------------------------------------------

// The rounding floor, up here because snap() is called from the first
// assignment below and a constant read above its own line is undef. See the
// note beside snap() further down for what that quietly did.
fuzz = 1e-6;

span = (pin_count - 1) * pin_pitch;

// screw bosses need corner room across the width the auto size would not
// otherwise leave. Along the length they tuck into the corners beside the
// board, so they cost nothing there.
screw_pad = closure == "screw" ? boss_d : 0;

pcb_l = board_l > 0 ? board_l : span + 2 * board_end_margin;
pcb_w = board_w;

/* The board sits hard against the inside of the USB end wall, so its socket
   lines up with the opening in that wall. That fixes the USB end, and the far
   end is the board plus the antenna bay — so the length is the board, not the
   header, plus the bay and two walls.
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
