markusg1234/ESP-Enclosure/(commit log)

2026-08-23 ESP-Enclosure: parametric ESP devkit case for OpenSCAD
    A single-file OpenSCAD enclosure that breaks the header out through the
    floor: the board sits on corner rests, its pins drop through a hole plate
    into a trough under each row, and Dupont connectors push up into those
    troughs so they finish flush with the floor.
    Includes a fit template and a hole-clearance coupon to print first, a
    floor relief that removes a third of the tray, an antenna bay, wire
    channels off each pin, ball latches for the lid, and SVG-driven vents.
    [esp-enclosure.scad]
2026-08-25 Refactor code structure for improved readability and maintainability
    [esp-enclosure.scad]
2026-08-26 Readme edit
    [esp-enclosure.scad]
2026-08-26 Update README and SCAD files to reflect changes in board margin calculations and dimensions
    [esp-enclosure.scad]
2026-08-27 Refactor ESP enclosure design: update comments, adjust dimensions, and remove coupon module
    - Revised comments for clarity and accuracy regarding part printing and fitting.
    - Changed the default pin_x_offset to -1.0 mm to better align with typical devkit headers.
    - Updated board width to a default of 25 mm and removed redundant parameters.
    - Adjusted side_margin and antenna_gap for improved fit and clearance.
    - Changed lid thickness from 2.0 mm to 1.6 mm for a more streamlined design.
    - Increased facets per full circle for better rendering quality.
    - Removed the coupon module and its associated comments, focusing on the template for fitting checks.
    - Updated the vent file reference for impro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
    [esp-enclosure.scad]
2026-08-27 Update README and SCAD files
    [esp-enclosure.scad]
2026-08-27 Enhance latch functionality: introduce latch_location parameter for flexible positioning and improve documentation on latch mechanics
    [esp-enclosure.scad]
